alx-1/EuroESP32/(commit log)

2021-03-21 Plaquette redimensionnée
    [EuroESP32.brd]
2021-03-22 v0.1
    TODO : TLC for the Labels
    [EuroESP32.brd, EuroESP32.sch]
